danwahl/solar-fan/eagle/solar-fan.brd

## EAGLE design eagle/solar-fan.brd (2016-11-28)

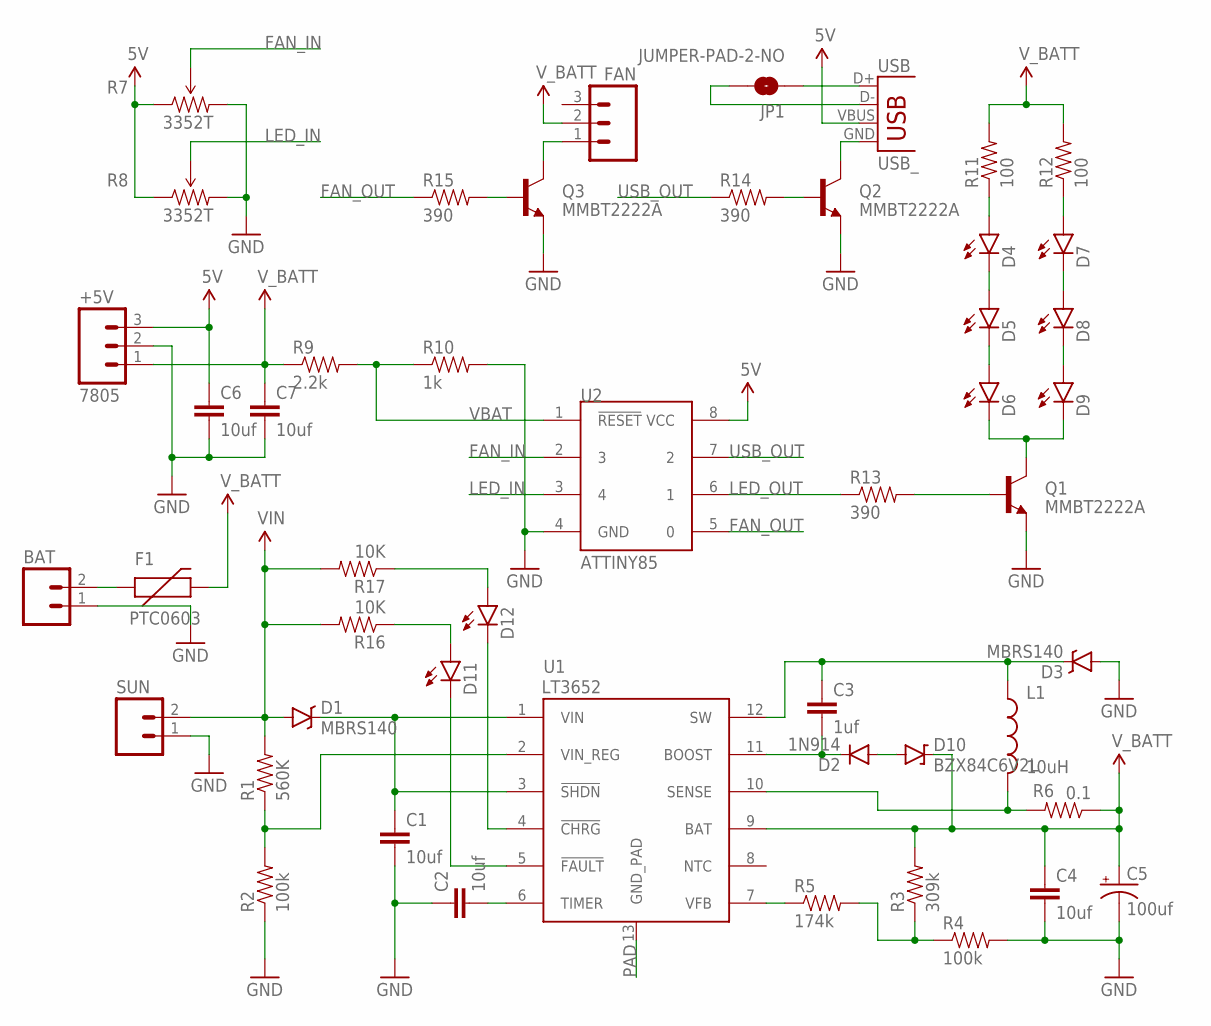
[picture p1: schematic solar-fan.sch]

Parts:
+5V: 7805; 1X03
BAT: M025MM; SCREWTERMINAL-5MM-2
C1, C2, C4, C6, C7: 10uf; 0603-CAP
C3: 1uf; 0603-CAP
C5: 100uf; CPOL-RADIAL-100UF-25V
D1, D3: MBRS140; SMA-DIODE
D2: 1N914; SOD-323
D4, D5, D6, D7, D8, D9, D11, D12: LED-WHITE0603; LED-0603
D10: BZX84C6V2L; SOT23-3
F1: PTC0603; 0603
FAN: M03POLAR; MOLEX-1X3
JP1: JUMPER-PAD-2-NO; PAD-JUMPER-2-NO_NO_SILK
L1: 10uH; RLB0912
Q1, Q2, Q3: MMBT2222A; SOT23-3
R1: 560K; 0603-RES
R2, R4: 100k; 0603-RES
R3: 309k; 0603-RES
R5: 174k; 0603-RES
R6: 0.1; 0603-RES
R7, R8: 3352T
R9: 2.2k; 0603-RES
R10: 1k; 0603-RES
R11, R12: 100; 0603-RES
R13, R14, R15: 390; 0603-RES
R16, R17: 10K; 0603-RES
SUN: M025MM; SCREWTERMINAL-5MM-2
U1: LT3652; MSOP-12_GND
U2: ATTINY85; 8P3
USB: USB_; USB-A-S-SILK-FEMALE

Connections:
5V: +5V.3, C6.1, R7.CCW, R8.CCW, U2.8 (VCC), USB.VBUS
BOOST: C3.2, D2.C, U1.11 (BOOST)
FAN_IN: R7.WIPER, U2.2 (3)
FAN_OUT: R15.1, U2.5 (0)
GND: +5V.2, BAT.1, C1.2, C2.1, C4.2, C5.2 (-), C6.2, C7.2, D3.A, Q1.2 (E), Q2.2 (E), Q3.2 (E), R2.1, R4.2, R7.CW, R8.CW, R10.2, SUN.1, U2.4 (GND)
LED_IN: R8.WIPER, U2.3 (4)
LED_OUT: R13.1, U2.6 (1)
unnamed: Q1.1 (B), R13.2
unnamed: Q2.1 (B), R14.2
unnamed: Q3.1 (B), R15.2
unnamed: FAN.1, Q3.3 (C)
unnamed: R3.1, R4.1, R5.2
unnamed: JP1.1, USB.D+
unnamed: JP1.2, USB.D-
unnamed: D2.A, D10.1 (A)
unnamed: D12.A, R17.1
unnamed: D12.C, U1.4 (!CHRG)
unnamed: D4.A, R11.1
unnamed: D7.A, R12.1
unnamed: D4.C, D5.A
unnamed: D7.C, D8.A
unnamed: D5.C, D6.A
unnamed: D8.C, D9.A
unnamed: D6.C, D9.C, Q1.3 (C)
unnamed: D11.C, U1.5 (!FAULT)
unnamed: Q2.3 (C), USB.GND
unnamed: D11.A, R16.1
unnamed: BAT.2, F1.1
PAD: U1.13 (GND_PAD)
SENSE: L1.2, R6.2, U1.10 (SENSE)
SHDN: C1.1, D1.C, U1.1 (VIN), U1.3 (!SHDN)
SW: C3.1, D3.C, L1.1, U1.12 (SW)
TIMER: C2.2, U1.6 (TIMER)
USB_OUT: R14.1, U2.7 (2)
VBAT: R9.2, R10.1, U2.1 (!RESET)
VFB: R5.1, U1.7 (VFB)
VIN: D1.A, R1.2, R16.2, R17.2, SUN.2
VIN_REG: R1.1, R2.2, U1.2 (VIN_REG)
V_BATT: +5V.1, C4.1, C5.1 (+), C7.1, D10.3 (C), F1.2, FAN.2, R3.2, R6.1, R9.1, R11.2, R12.2, U1.9 (BAT)

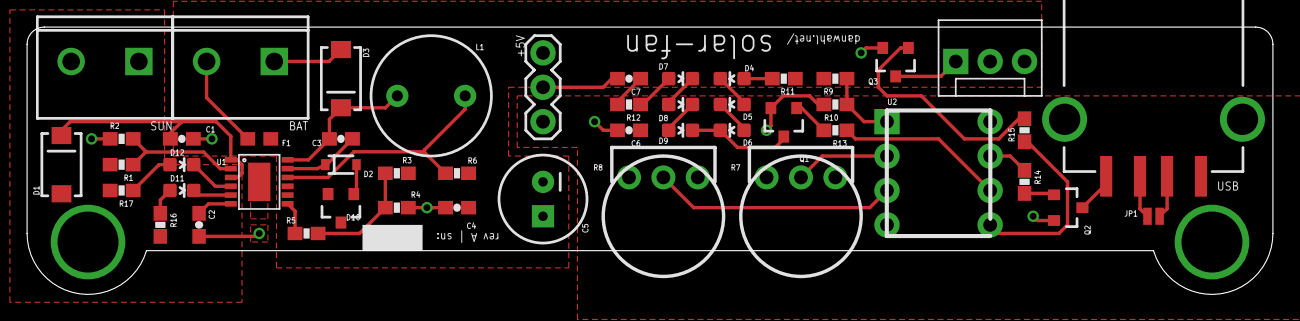
[picture p2: board solar-fan.brd from above]

Board: 2 copper layers, 92.0 x 19.7 mm, 49 parts (0 on the bottom side), 38 nets.
