danwahl/solar-fan/(commit log)

2016-08-16 adding arduino test project
2016-08-16 switching sensors
2016-09-12 eagle initial commit, schematic only
    [solar-fan.brd, solar-fan.sch]
2016-09-14 first draft of board layout, minor schematic fixes
    [solar-fan.brd, solar-fan.sch]
2016-09-15 minor layout updates, adding PNs to schematic
    [solar-fan.brd, solar-fan.sch]
2016-09-17 layout update, bom, components
    [solar-fan-bom.csv, solar-fan.brd, solar-fan.sch]
2016-09-18 updated fan connector and layout, silk screen, mfg files
    [solar-fan-bom.csv, solar-fan.brd, solar-fan.sch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]
2016-09-18 changed pn for c1 and c4
    [solar-fan-bom.csv, solar-fan.brd, solar-fan.sch]
2016-09-19 rev - build
    [solar-fan-bom.csv, solar-fan.brd, solar-fan.sch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]
2016-09-26 solar fan firmware first draft
2016-10-13 - updated charge voltage - led/cap placement - proper fan vs. usb out on micro - changed transistors to smd - solder mask change for gnd pad - added status leds for chager - changed battery/solar con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
    [solar-fan.brd, solar-fan.sch]
2016-10-17 rev A build
    [solar-fan.brd, solar-fan.sch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]
2016-11-07 solar fan sw initial commit, rev A
2016-11-08 solar fan working, no idle, 8 MHz
2016-11-14 fix for idle, file structure for arduino code
    [solar-fan.ino]
2016-11-28 minor electronics/software updates, still rev A
    [solar-fan-bom.csv, solar-fan.brd, solar-fan.sch]
